jiredo/EnragedRabbitProject/Documentation/Enraged Rabbit Project - Sourcing Guide.xlsx

Sheet: Carrot Feeder
Sourcing Guide for Ette's Enraged Rabbit : Carrot Feeder
BOM for the Enraged Rabbit Carrot Feeder V1.1! This is for a N channels system (if you want 6 filaments then replace N by 6). This doesn't include the BOM for the toolhead sensor (for that look on the other tabs)!
# Channels | 9 | Number of channels |  |  |  | ALL ALI EXPRESS LINKS ARE AFFILIATED =)
 | Component | Spec | Size/Length/ variable qty | Qty | All sizes | Source 1 | Source 2 | Source 3 | Source 4 | Notes
Electronics | NEMA14 Motor 14HS11-1004S |  |  | 1 | All | Stepper Online (https://www.omc-stepperonline.com/nema-14-bipolar-1-8deg-12-5ncm-17-7oz-in-1a-3-5v-35x35x28mm-4-wires.html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) | Aliexpress (https://www.aliexpress.com/item/33015617147.html)
Electronics | NEMA17 Motor 17HS08-1004S |  |  | 1 | All | Stepper Online (https://www.omc-stepperonline.com/nema-17-stepper-motor/nema-17-bipolar-1-8deg-16ncm-22-6oz-in-1a-3-7v-42x42x20mm-4-wires.html) | Stepper Online (Ali) (https://s.click.aliexpress.com/e/_AoYqnK) | Amazon DE (https://www.amazon.de/STEPPERONLINE-Schrittmotor-Bipolar-42x42x20mm-4-Dr%C3%A4hte/dp/B06XVM38YW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)
Electronics | towerpro MG90S servo |  |  | 1 | All | Amazon US (https://www.amazon.com/Maxmoral-Upgraded-Digital-Vehicle-Helicopter/dp/B07NV476P7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) | Amazon FR (https://amzn.to/3E7eDK3) | Amazon DE (https://www.amazon.de/ZHITING-MG90S-Metallgetriebe-Hubschrauber-Flugzeug/dp/B088NQM7XW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) | Aliexpress (https://s.click.aliexpress.com/e/_AONF2h) | Knock off will work
Electronics | Stepper drivers (any, but TMC2209 are nice) |  |  | 2 |  | Aliexpress (https://s.click.aliexpress.com/e/_A3ZzxA) | Amazon US (https://www.amazon.com/BIGTREETECH-TMC2209-Stepper-Printer-Motherboard/dp/B08SMDY3SQ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) | Amazon FR (https://amzn.to/3la60G6) | Amazon DE (https://www.amazon.de/KINGPRINT-TMC2209-Stepper-Driver-Printer/dp/B07WC71M4R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) | should have left over from 2.4BOM
Electronics | TCRT5000 sensor pcb |  |  | 1 |  | Amazon US (https://www.amazon.com/SUBALIGU-TCRT5000-Infrared-Follower-Avoidance/dp/B08HLW4PPD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) | Aliexpress (https://s.click.aliexpress.com/e/_ADrfkY) | Lab4450 (part of the kit) (https://lab4450.com/product-category/ercf/) |  | There are many versions. The black PCB is mandatory. Try to get the version with the off-centered hole rather than the center one.
Electronics | Omron Mouse Button - Micro Switch |  |  | 1 |  | Digikey (https://www.digikey.com/product-detail/en/omron-electronics-inc-emc-div/D2F-5L/Z8846-ND/8593137)
Hardware | N sets of bondtechs gears | qty = N + 1 | 10 | Variable |  | TwoTrees (https://s.click.aliexpress.com/e/_A7mydO)
Hardware | LM8UU bearings or RJ4JP-01-08 | 8mm |  | 2 |  | TriangleLab (https://s.click.aliexpress.com/e/_9xJ8NI)
Hardware | M5 threaded rods | Length = 25 + N*21 + ceil(N/3 -1)*5 mm | 224 | 2 |  | Aliexpress (https://s.click.aliexpress.com/e/_A4l008) |  |  |  | You can also find it at your local hardware stores.
Hardware | 8mm smooth rods | Length = 40 + N*21 + ceil(N/3 - 1)*5 mm | 239 | 2 |  | TwoTrees (https://s.click.aliexpress.com/e/_9uJaVm) |  |  |  | You can also find it at your local hardware stores.
Hardware | D-cut 5mm shaft | Length = 70 + N*21 + ceil(N/3 - 1)*5 mm | 269 | 1 |  | POWGE (https://s.click.aliexpress.com/e/_ABzAlO) | AliExpress FULL, NO D-CUT (https://s.click.aliexpress.com/e/_AefrTe) |  |  | Powge can sell shafts with the D-cut already, but it's bertween 10€ and 20€ for 1 shaft; which is quite expensive. You can order a round 5mm shaft elsewhere (for like 2€) and do the D cuts yourself, this is a much cheaper option
Hardware | MR623ZZ bearing |  |  | 1 | All | TriangleLab (https://s.click.aliexpress.com/e/_9ikulA)
Hardware | MR85ZZ bearings | qty = 4 + ceil(N/3 - 1) | 6 | Variable |  | TriangleLab (https://s.click.aliexpress.com/e/_AfBHbm)
Fasteners | M3 threaded inserts | M3x5x4mm. qty = 28 |  | 28 | All | Aliexpress - M3x5x4 (https://s.click.aliexpress.com/e/_AavdJq)
Fasteners | M5x30 BHCS |  |  | 2 |  | Bolt Depot (https://www.boltdepot.com/Product-Details.aspx?product=15651) | McMaster-Carr (100 pack) (https://www.mcmaster.com/91239A236)
Fasteners | M5x16 BHCS |  |  | 1 |  | Bolt Depot (https://www.boltdepot.com/Product-Details.aspx?product=15648) | McMaster-Carr (100 pack) (https://www.mcmaster.com/91239A232)
Fasteners | M5 nuts |  |  | 4
Fasteners | M5 nylock nuts |  |  | 5
Fasteners | M5 washers | whatever thickness |  | 2
Fasteners | M3x8 SHCS |  |  | 22 |  | Bolt Depot (https://www.boltdepot.com/Product-Details.aspx?product=13635) | McMaster-Carr (100 pack) (https://www.mcmaster.com/91290a113)
Fasteners | M3x8 BHCS |  |  | 5
Fasteners | M3x12 SHCS |  |  | 3 |  | Bolt Depot (https://www.boltdepot.com/Product-Details.aspx?product=13637) | McMaster-Carr (100 pack) (https://www.mcmaster.com/91290A117)
Fasteners | M3x16 SHCS | qty = 4 + N | 13 | Variable |  | Bolt Depot (https://www.boltdepot.com/Product-Details.aspx?product=13638) | McMaster-Carr (100 pack) (https://www.mcmaster.com/91290A120)
Fasteners | M3x20 SHCS |  |  | 7
Fasteners | M3x40 SHCS |  |  | 2
Fasteners | M3 washers (could also be the DIN125 below) | whatever thickness |  | 2
Fasteners | M3 DIN125 Steel Washer | 7mm Outer diameter, 0.5mm thickness STEEL | 9 | Variable |  | Bolt Depot (https://www.boltdepot.com/Product-Details.aspx?product=4524) |  |  |  | We need those to be magnetic. Stainless Steel WON'T work
Fasteners | M2x8 SHCS or M2x10 SHCS |  |  | 2
Motion | GT2 belt 6mm (open) | Length = 150 + N*42 + ceil(N/3 - 1)*10 mm | 548 | 1 |  | POWGE (https://s.click.aliexpress.com/e/_AFoHHw)
Motion | GT2 20T Pulley 6 mm, 5mm bore |  |  | 3 |  | POWGE (https://s.click.aliexpress.com/e/_9u6cA0)
Motion | GT2 20T Toothed Idler 6 mm, 5mm bore |  |  | 1 |  | POWGE (https://s.click.aliexpress.com/e/_APR41m)
Motion | GT2 188m Belt loop 6mm |  |  | 1 |  | POWGE (https://s.click.aliexpress.com/e/_AoQ8jE)
Misc | 6mm x 3mm Round Neodymium Magnets | 6x3mm. qty = 4 + Nx3 | 31 | Variable |  | Aliexpress (https://s.click.aliexpress.com/e/_A00Gse) |  |  |  | should have left over from 2.4BOM
Misc | Bowden Clip | qty = 1 + N | 10 | Variable |  | TriangleLab (https://s.click.aliexpress.com/e/_ADrrha)
Misc | Bowden Fitting | qty = 1 + N | 10 | Variable |  | TriangleLab (https://s.click.aliexpress.com/e/_AW9RVK)
Misc | 7X7 Drag chain |  |  | 1 |  | TwoTress (https://s.click.aliexpress.com/e/_A4lTBQ)
Option 1A : Nominal setup, MicroFit3 connectors on the ERCF side to connect to whatever board you want (typically your printer board). This assumes you won"t use the ERCF easy BRD
Cables | MicroFit3 Male Pin (43031-0007) |  |  | 26
Cables | MicroFit3 Female Pin (43030-0007) |  |  | 26
Cables | MicroFit Connector Receptacle 4 Position (43645-0400) |  |  | 4
Cables | MicroFit Connector Plug 4 Position (43640-0401) |  |  | 4
Cables | MicroFit Connector Receptacle 5 Position (43645-0500) |  |  | 2
Cables | MicroFit Connector Plug 5 Position (43640-0501) |  |  | 2
Option 1B : ERCF Easy BRD (dedicated board for the ERCF), no need for the MicroFit3 connectors listed for option 1A
Electronics | ERCF Easy BRD |  |  | 1 |  | Lab4450 (part of the kit) (https://lab4450.com/product-category/ercf/) |  |  |  | The ERCF Easy BRD is an open source ERCF board made by Tircown, see here (https://github.com/Tircown/ERCF-easy-brd)

Sheet: Carrot Patch
Sourcing Guide for Ette's Enraged Rabbit : Carrot Patch
This is for a single spool holder |  |  |  |  |  | ALL ALI EXPRESS LINKS ARE AFFILIATED =)
 | Component | Spec | Size/Length | Qty | All sizes | Recommended |  | Notes
Hardware | 608ZZ bearing |  |  | 1
Fasteners | M3 threaded inserts | M3x5x4mm |  | 4 |  | Aliexpress - M3x5x4 (https://s.click.aliexpress.com/e/_AavdJq)
Fasteners | M5x30 BHCS |  |  | 1 |  | Bolt Depot (https://www.boltdepot.com/Product-Details.aspx?product=15651) | McMaster-Carr (100 pack) (https://www.mcmaster.com/91239A236)
Fasteners | M5 nylock nuts |  |  | 1
Fasteners | M3x8 SHCS |  |  | 2 |  | Bolt Depot (https://www.boltdepot.com/Product-Details.aspx?product=13635) | McMaster-Carr (100 pack) (https://www.mcmaster.com/91290a113)
Fasteners | M3x16 SHCS |  |  | 1
Fasteners | M3X20 SHCS |  |  | 1
Misc | PTFE tubing 2.5 mm ID 4 mm OD |  | ~40cm | 1 |  | Aliexpress (https://s.click.aliexpress.com/e/_APSGDe)
Option 1 : Only use ECAS connectors. Use either Option 1 or 2
Misc | Bowden Clip |  |  | 2 |  | TriangleLab (https://s.click.aliexpress.com/e/_AeTnAk)
Misc | Bowden Fitting |  |  | 2 |  | TriangleLab (https://s.click.aliexpress.com/e/_9I62Mc)
Option 2 : 1 ECAS connector and 1 M10 ptfe pressfit (with the ptfe tube going through). Use either Option 1 or 2
Misc | M10 PTFE pressFit (ptfe goes through) |  |  | 1
Misc | Bowden Clip |  |  | 1 |  | TriangleLab (https://s.click.aliexpress.com/e/_AeTnAk)
Misc | Bowden Fitting |  |  | 1 |  | TriangleLab (https://s.click.aliexpress.com/e/_9I62Mc)

Sheet: Toolhead Sensor
Sourcing Guide for Ette's Enraged Rabbit : Toolhead sensor (New Tircown's design!)
This is for a single toolhead sensor (BOM is the same for AB, Galileo and LGX extruders) |  |  |  |  |  | ALL ALI EXPRESS LINKS ARE AFFILIATED =)
 | Component | Spec | Size/Length | Qty | All sizes | Source 1 | Source 2 | Notes
Electronics | AH3364Q-P-B Hall Effect sensor (SIP) |  |  | 1 |  | Digikey (https://www.digikey.com/en/products/detail/diodes-incorporated/AH3364Q-P-B/6575180) | Lab4450 (part of the kit) (https://lab4450.com/product-category/ercf/) | Get the SIP3 housing version, not the SMD one. You can also use the AH3364Q-P-A, difference will be in the packaging and the legs shape
Fasteners | M3 DIN125 Steel Washer | 7mm Outer diameter, 0.5mm thickness STEEL |  | 1 |  | Bolt Depot (https://www.boltdepot.com/Product-Details.aspx?product=4524) |  | We need those to be magnetic. Stainless Steel WON'T work
Misc | 6mm x 3mm N52 Round Neodymium Magnet | You want a legit N52 magnet |  | 1 |  |  |  | Find a legit N52 magnet
Fasteners | M3x8 SHCS |  |  | 1
Fasteners | M3x12 SHCS |  |  | 1
Option 1 : Galileo Clockwork toolhead
Optionnal | JST XH 3 pins male connector |  |  | 1 |  | Digikey (https://www.digikey.com/en/products/detail/jst-sales-america-inc/B3B-XH-AM-LF-SN/1651029) |  | You can use whatever kind of connector you prefer, but the JST XH can be inserted into the Galileo main body
Option : Reverse Bowden coupler (for AB//CW1, Galileo and CW2)
Misc | Bowden Coupler PC4-M6 Feed Through | Feed through version! |  | 1 |  | Aliexpress (https://s.click.aliexpress.com/e/_AtOIcN) |  | You need the feed through version (usually the silver color with black collet)
