jiredo/EnragedRabbitProject/usermods/CW2_with_ECAS_and_optional_sensor/STL/Alternates/main_body_with_ECAS_and_sensor_tight.stl

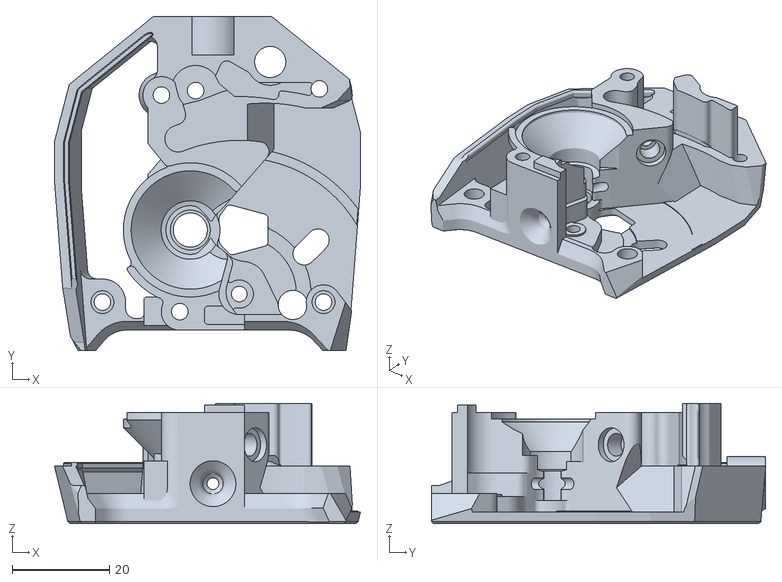
[picture p4: CAD file, 2023-01-10]
usermods/CW2_with_ECAS_and_optional_sensor/STL/Alternates/main_body_with_ECAS_and_sensor_tight.stl
62.8 x 68.7 x 24.7
