jiredo/EnragedRabbitProject/Filament_Sensor/CAD/LGX_on_AfterBurner_ERCF_Sensor.step

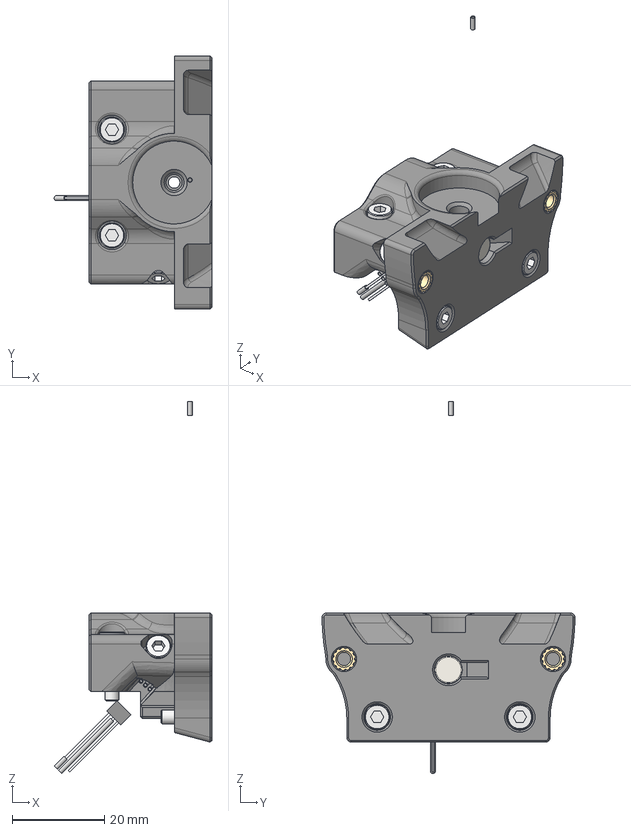
[picture p5: CAD file, 2023-01-10]
Filament_Sensor/CAD/LGX_on_AfterBurner_ERCF_Sensor.step
34.3 x 55.0 x 80.8 mm
M3X8 SHCS v2 x 2
M3X8 SHCS v2 (1)
Magnet6x3 v1
M3X12 SHCS v2 x 2
M3 Washer
AH3364Q-P-B v4
M3 Threaded Insert v5 x 4
