jiredo/EnragedRabbitProject/usermods/CW2_with_ECAS_and_optional_sensor/CAD/Alternates/Test_block_tight.step

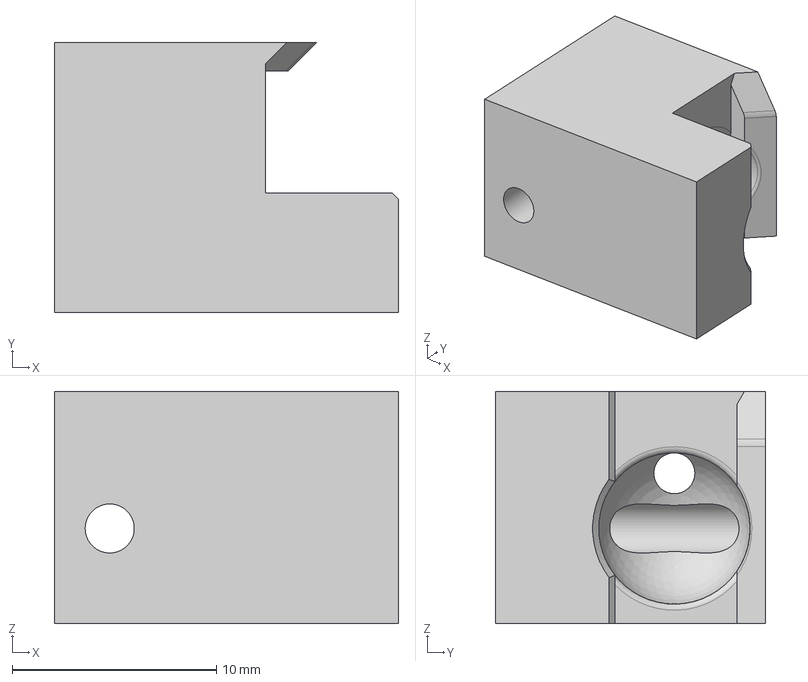
[picture p6: CAD file, 2023-01-10]
usermods/CW2_with_ECAS_and_optional_sensor/CAD/Alternates/Test_block_tight.step
16.8 x 13.2 x 11.3 mm
