jiredo/EnragedRabbitProject/usermods/CW2_with_ECAS_and_optional_sensor/CAD/CW2_with_ECAS_and_sensor.step

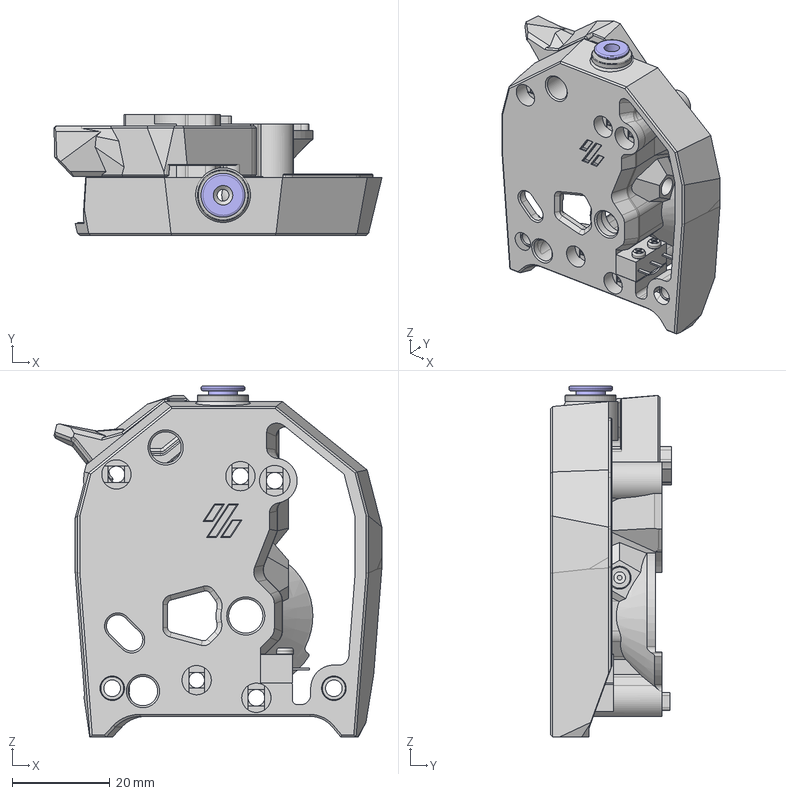
[picture p7: CAD file, 2023-01-10]
usermods/CW2_with_ECAS_and_optional_sensor/CAD/CW2_with_ECAS_and_sensor.step
67.2 x 24.7 x 71.9 mm
ECAS latch
Main body
Release clip
Seal
D2F_ACTUATOR
D2F_BASE
M2x10 self-tapping screw x 2
Composite main body
Ball bearing
