jiredo/EnragedRabbitProject/usermods/CW2_with_ECAS_and_optional_sensor/STL/[a]_latch.stl

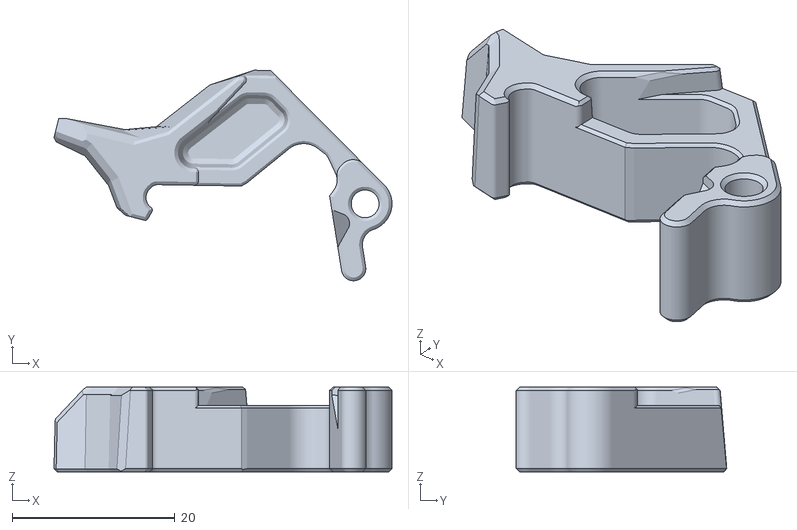
[picture p8: CAD file, 2023-01-10]
usermods/CW2_with_ECAS_and_optional_sensor/STL/[a]_latch.stl
41.5 x 25.8 x 10.4
