jiredo/EnragedRabbitProject/usermods/CW2_with_ECAS_and_optional_sensor/CAD/CW2_with_ECAS.step

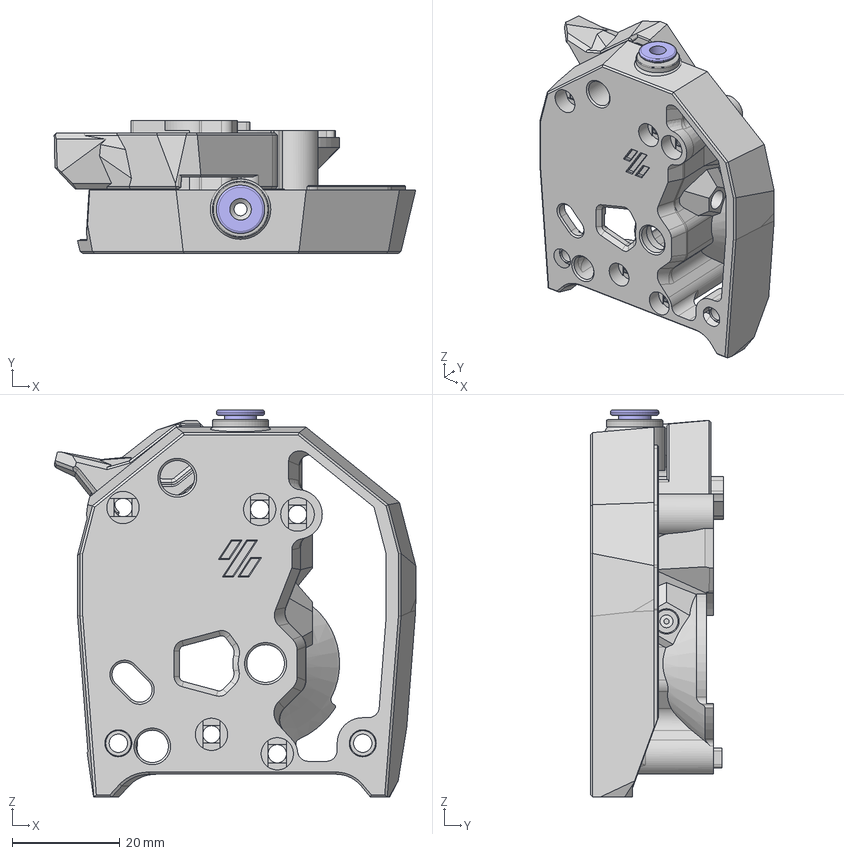
[picture p9: CAD file, 2023-01-10]
usermods/CW2_with_ECAS_and_optional_sensor/CAD/CW2_with_ECAS.step
67.2 x 24.7 x 71.9 mm
Main body
Release clip
Seal
Main body (1)
Latch (1)
