jiredo/EnragedRabbitProject/usermods/CW2_with_ECAS_and_optional_sensor/CAD/Alternates/Test_block_loose.step

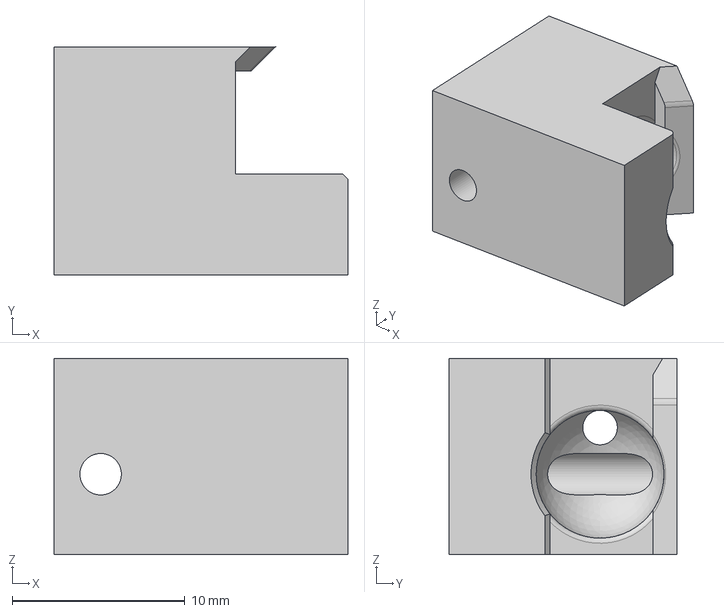
[picture p10: CAD file, 2023-01-10]
usermods/CW2_with_ECAS_and_optional_sensor/CAD/Alternates/Test_block_loose.step
17.0 x 13.2 x 11.3 mm
