jiredo/EnragedRabbitProject/(list of files, cad)

Other CAD files:
usermods/CW2_with_ECAS_and_optional_sensor/STL/main_body_with_ECAS.stl
usermods/CW2_with_ECAS_and_optional_sensor/STL/main_body_with_ECAS_and_sensor.stl
usermods/CW2_with_ECAS_and_optional_sensor/CAD/Alternates/CW2_with_ECAS_and_sensor_loose.step
usermods/CW2_with_ECAS_and_optional_sensor/CAD/Test_block.step
usermods/CW2_with_ECAS_and_optional_sensor/CAD/Alternates/CW2_with_ECAS_and_sensor_tight.step
usermods/CW2_with_ECAS_and_optional_sensor/STL/Alternates/test_block_loose.stl
usermods/CW2_with_ECAS_and_optional_sensor/STL/Alternates/test_block_tight.stl
usermods/CW2_with_ECAS_and_optional_sensor/STL/test_block.stl
