jiredo/EnragedRabbitProject/(commit log)

2022-06-30 No toolhead sensor software, split parameter file
    Parameters are now located in a dedicated file (ercf_parameters.cfg) for easier updates.
    This software version is dedicated to systems without any toolhead sensor, only relying on the encoder data from the ercf. As a result the system is simpler and faster, but there are some downsides for now.
    Typically in situations where the ercf state is unknown (e.g. after a reboot), we can't know for sure if filament is below the extruder gear or not, resulting in redundant moves to eject filament.
    [ercf_parameters.cfg, ercf_software.cfg]
2022-06-30 Bugfix on the _ERCF_LOAD_FILAMENT_IN_EXTRUDER
    [ercf_software.cfg]
2022-06-30 Fixed the unload
    [ercf_software.cfg]
2022-07-21 Minor update
    [ercf_hardware.cfg, ercf_parameters.cfg]
2022-12-30 removed CryoPatch
    [BackPanel-01.SLDPRT, BottomPanel.DXF, BottomPanel.SLDPRT, CUBIC_CONNECTOR_30X30.SLDPRT, Frame.SLDASM, Panel-01.DXF, Panel-01.SLDPRT, Rex3030-410mm.SLDPRT]
2023-01-09 move custom items to private git
    [3030-Feet-01.SLDPRT, 3030-Feet-01.STL, 3030-Feet-02.SLDPRT, 3030-Feet-02.STL, 3030-Feet-03.SLDPRT, 3030-Feet-03.STL, 3030-Feet.STL]
